zhangoumeng/rhizo_fluorescence_scanner/profile_470.bmp

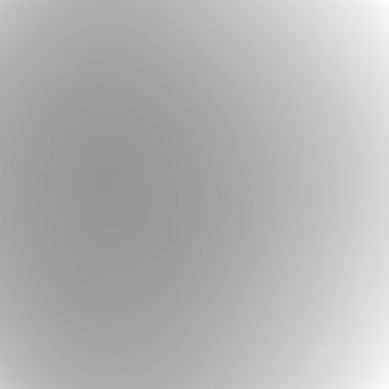
profile_470.bmp
