zhangoumeng/rhizo_fluorescence_scanner/profile_565.bmp

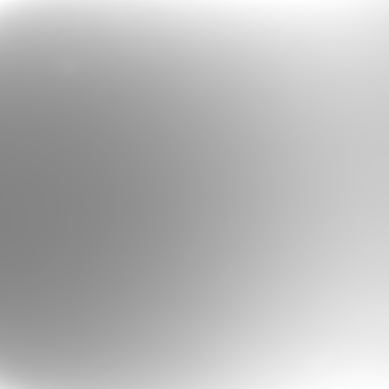
profile_565.bmp
