zhangoumeng/rhizo_fluorescence_scanner/compile_instructions.txt

1. Activate the scanner Anaconda environment (Python 3.8.20) and open the Anaconda Prompt.

2. Navigate to the folder containing the scanner control code.

3. Run the following command to build a standalone .exe file using PyInstaller:

pyinstaller --onefile --windowed main.py ^
--add-binary "C:\Users\biophotonics\anaconda3\envs\scanner\Lib\site-packages\imagingcontrol4\ic4core.dll;imagingcontrol4" ^
--add-binary "C:\Users\biophotonics\anaconda3\envs\scanner\Lib\site-packages\imagingcontrol4\ic4gui.dll;imagingcontrol4" ^
--hidden-import=scipy.io --hidden-import=scipy.io.matlab --hidden-import=scipy.io.matlab.mio5

or

pyinstaller --onefile --console main.py ^
--add-binary "C:\Users\biophotonics\anaconda3\envs\scanner\Lib\site-packages\imagingcontrol4\ic4core.dll;imagingcontrol4" ^
--add-binary "C:\Users\biophotonics\anaconda3\envs\scanner\Lib\site-packages\imagingcontrol4\ic4gui.dll;imagingcontrol4" ^
--hidden-import=scipy.io --hidden-import=scipy.io.matlab --hidden-import=scipy.io.matlab.mio5

for troubleshooting.
